Nicovf23/grupo-1800/Archivos de kicad/documentacion/cdj_revD_3D.png

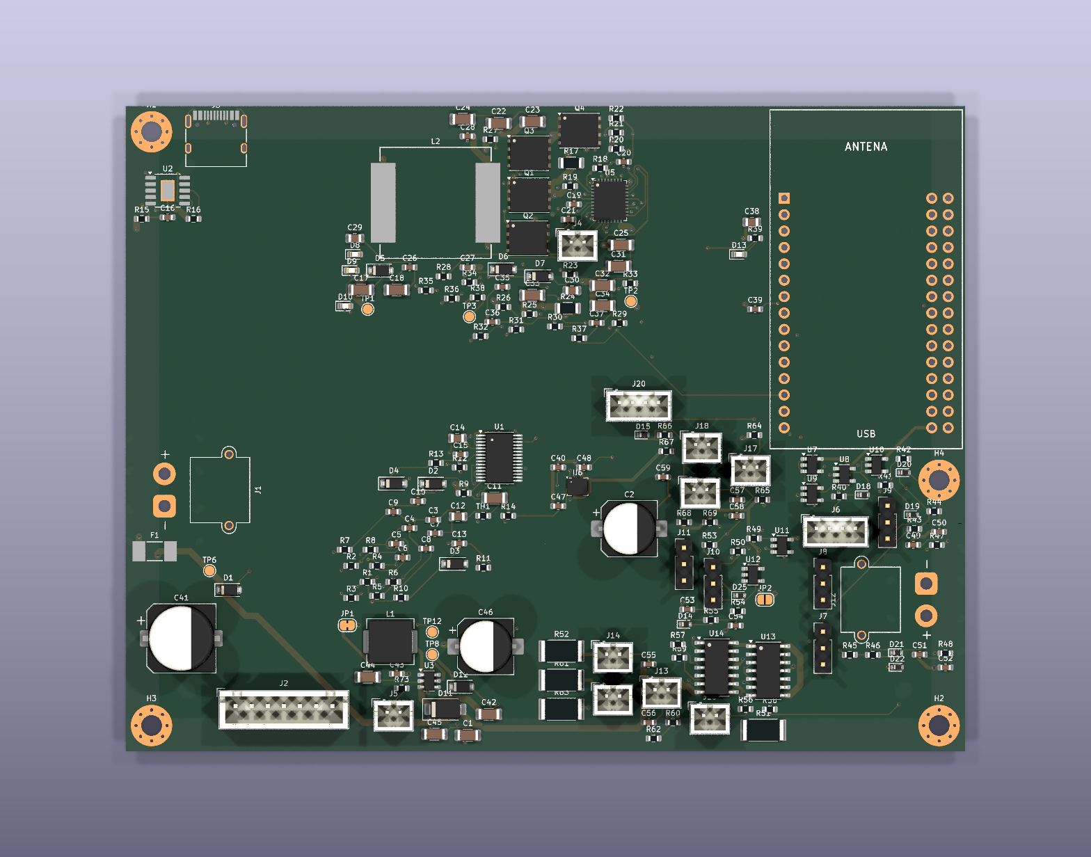
Archivos de kicad/documentacion/cdj_revD_3D.png
