Nicovf23/grupo-1800/Archivos de kicad/fabricacion_PRELIMINAR/cdj_revD.step

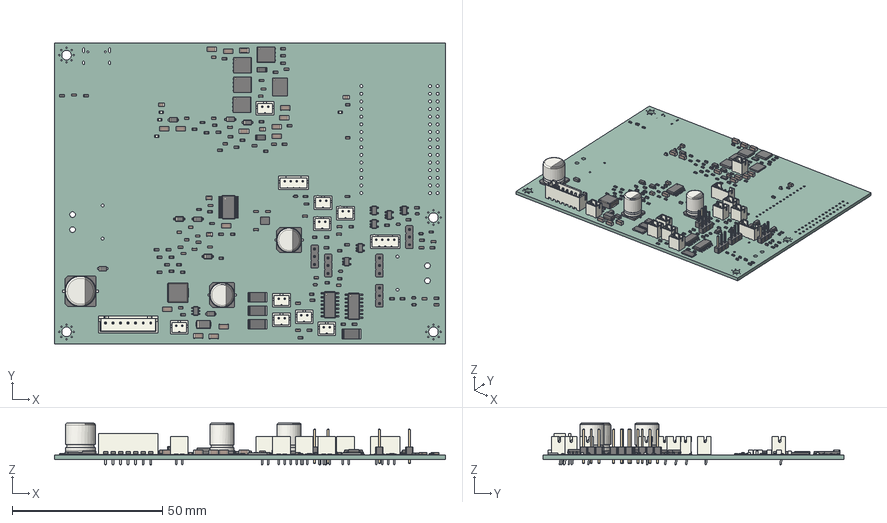
[picture p5: CAD file, 2026-11-05]
Archivos de kicad/fabricacion_PRELIMINAR/cdj_revD.step
130.0 x 100.0 x 13.9 mm
R_0603_1608Metric x 65
C_1206_3216Metric x 15
JST_PH_B2B-PH-K_1x02_P2.00mm_Vertical x 9
D_SOD-523 x 8
PinHeader_1x03_P2.54mm_Vertical x 5
SOT-23-5 x 6
C_0603_1608Metric x 36
TDSON-8-1 x 4
LED_0603_1608Metric x 4
D_SOD-123 x 5
R_2512_6332Metric x 4
SOIC-14_3.9x8.7mm_P1.27mm x 2
CP_Elec_8x10.5 x 2
C_0805_2012Metric x 5
D_SOD-123F x 3
D_SMA
LGA-14_3x2.5mm_P0.5mm_LayoutBorder3x4y
TSSOP-30_4.4x7.8mm_P0.5mm
R_1206_3216Metric x 2
QFN-36-1EP_5x6mm_P0.5mm_EP3.6x4.6mm
L_APV_APH0630
JST_PH_B4B-PH-K_1x04_P2.00mm_Vertical x 2
CP_Elec_10x10.5
TSOT-23-6
JST_XH_B7B-XH-A_1x07_P2.50mm_Vertical
cdj_revD_PCB
