Nicovf23/grupo-1800/Tareas/LA CAJA 1800.FCStd

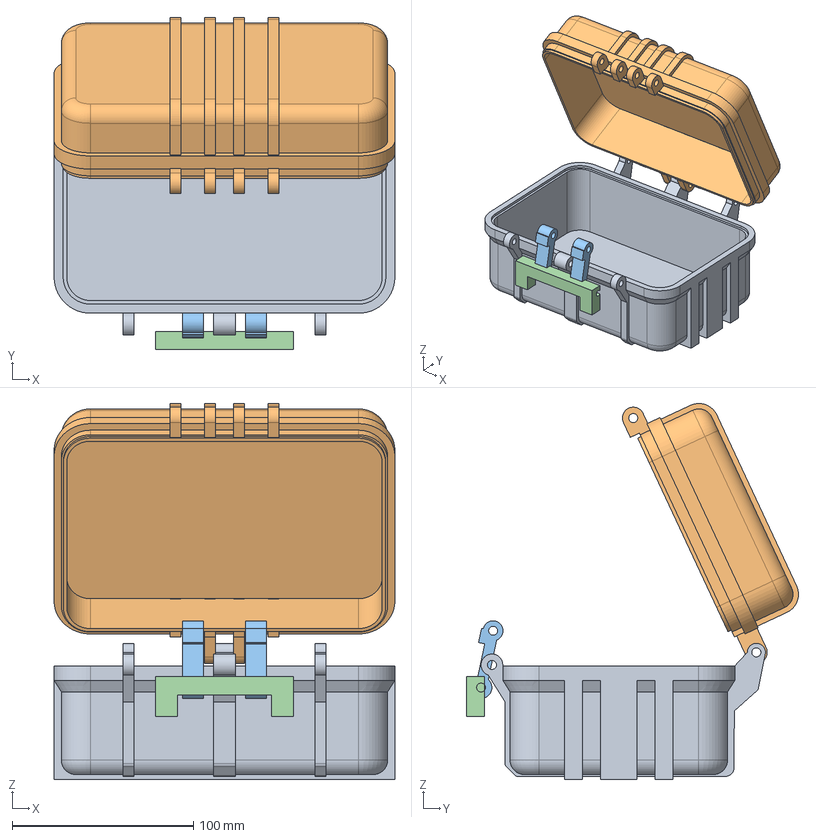
[picture p6: CAD file, 2026-10-15]
Tareas/LA CAJA 1800.FCStd
188.0 x 183.1 x 207.4 mm
cuerpo de caja
tapa
Cierres_Frontales
Asa_Transporte
