Nicovf23/grupo-1800/Tareas/cajita nueva.FCStd

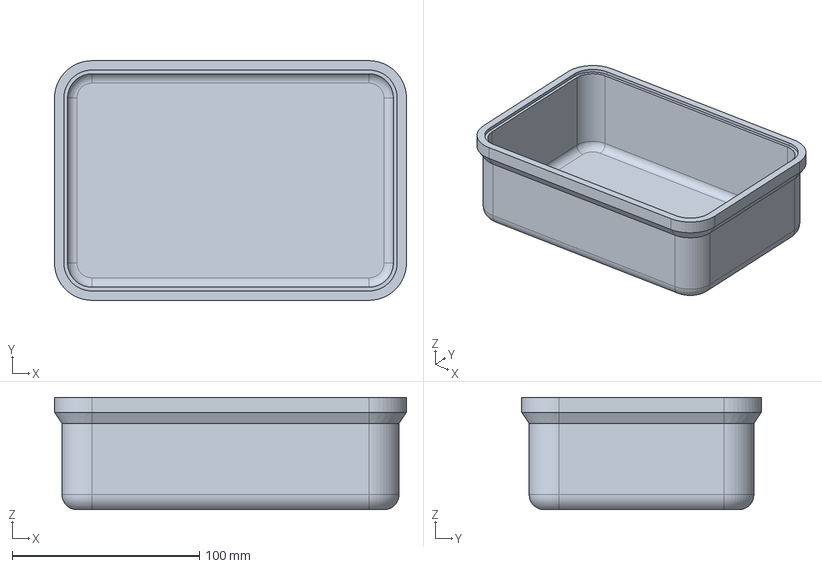
[picture p7: CAD file, 2026-10-15]
Tareas/cajita nueva.FCStd
188.0 x 128.0 x 60.0 mm
