Nicovf23/grupo-1800/Archivos de kicad/reportes/verificacion_netlist_revD.txt

pines esperados: 575  coinciden: 575  mal: 0
nets fusionadas: ninguna
