Nicovf23/grupo-1800/Archivos de kicad/documentacion/cdj_revD_esquematico.pdf

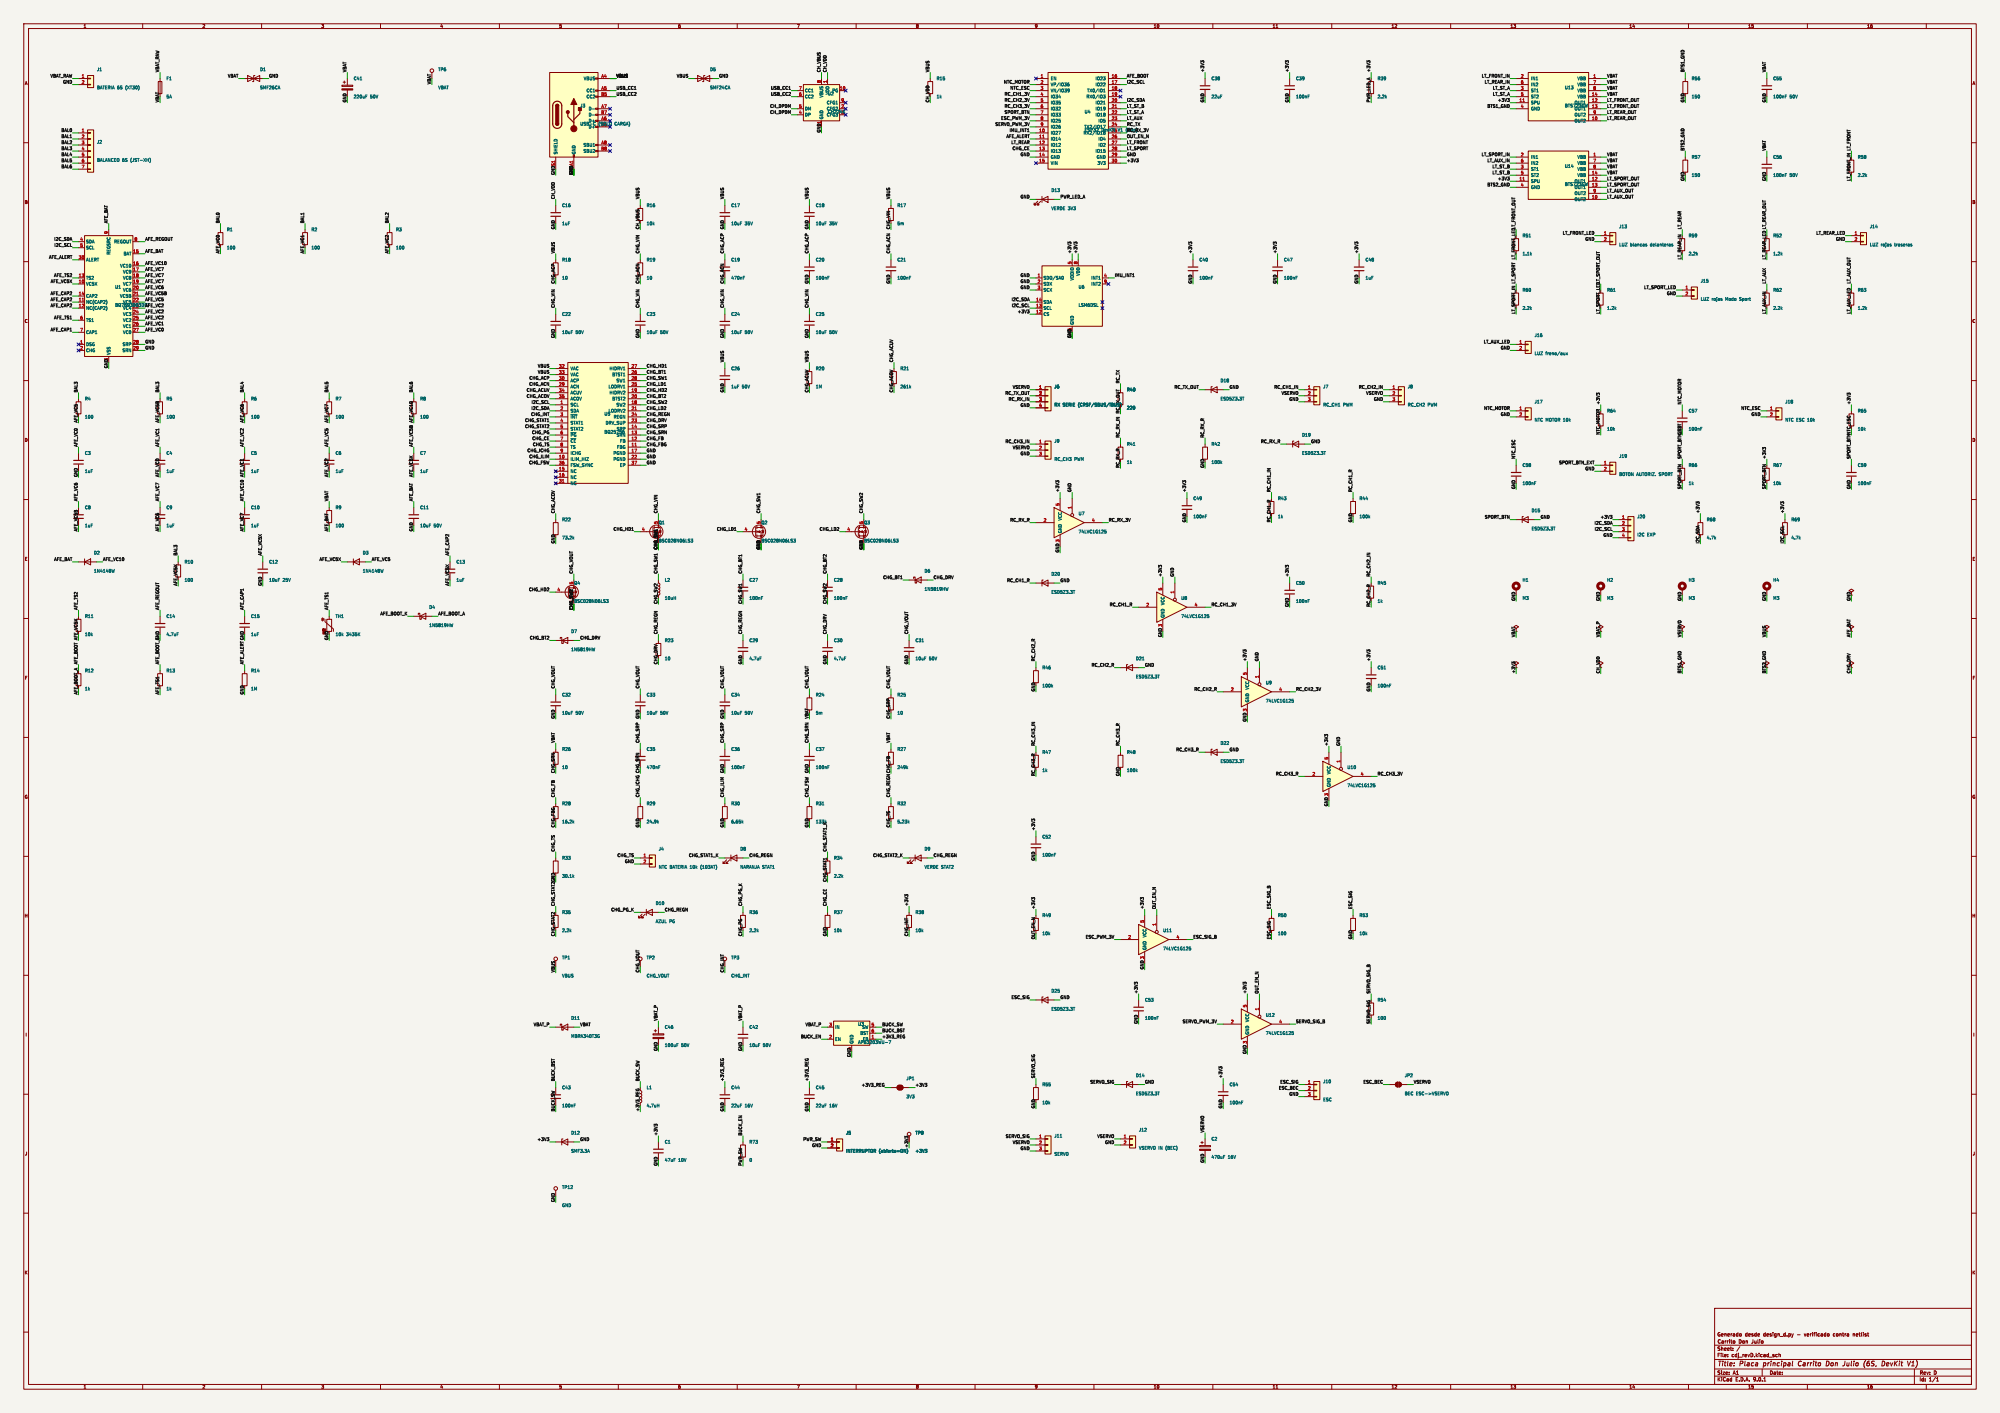
[picture p8: page 1]

9 REGOUT 8 BAT 15 VC10 16 VC9 17 VC8 18 VC7 19 VC6 20 VC5B 21 VC5 22 VC4 23 VC3 24 VC2 25 VC1 26 VC0 27 SRP 28 SRN 29 SDA 4 SCL 5 DSG 1 CHG 2 VSS

J6RX SERIE (CRSF/SBUS/iBUS) R10
