Nicovf23/grupo-1800/Archivos de kicad/proyecto_revD/cdj_revD.kicad_pcb

## KiCad design Archivos de kicad/proyecto_revD/cdj_revD.kicad_pcb (2026-11-05)

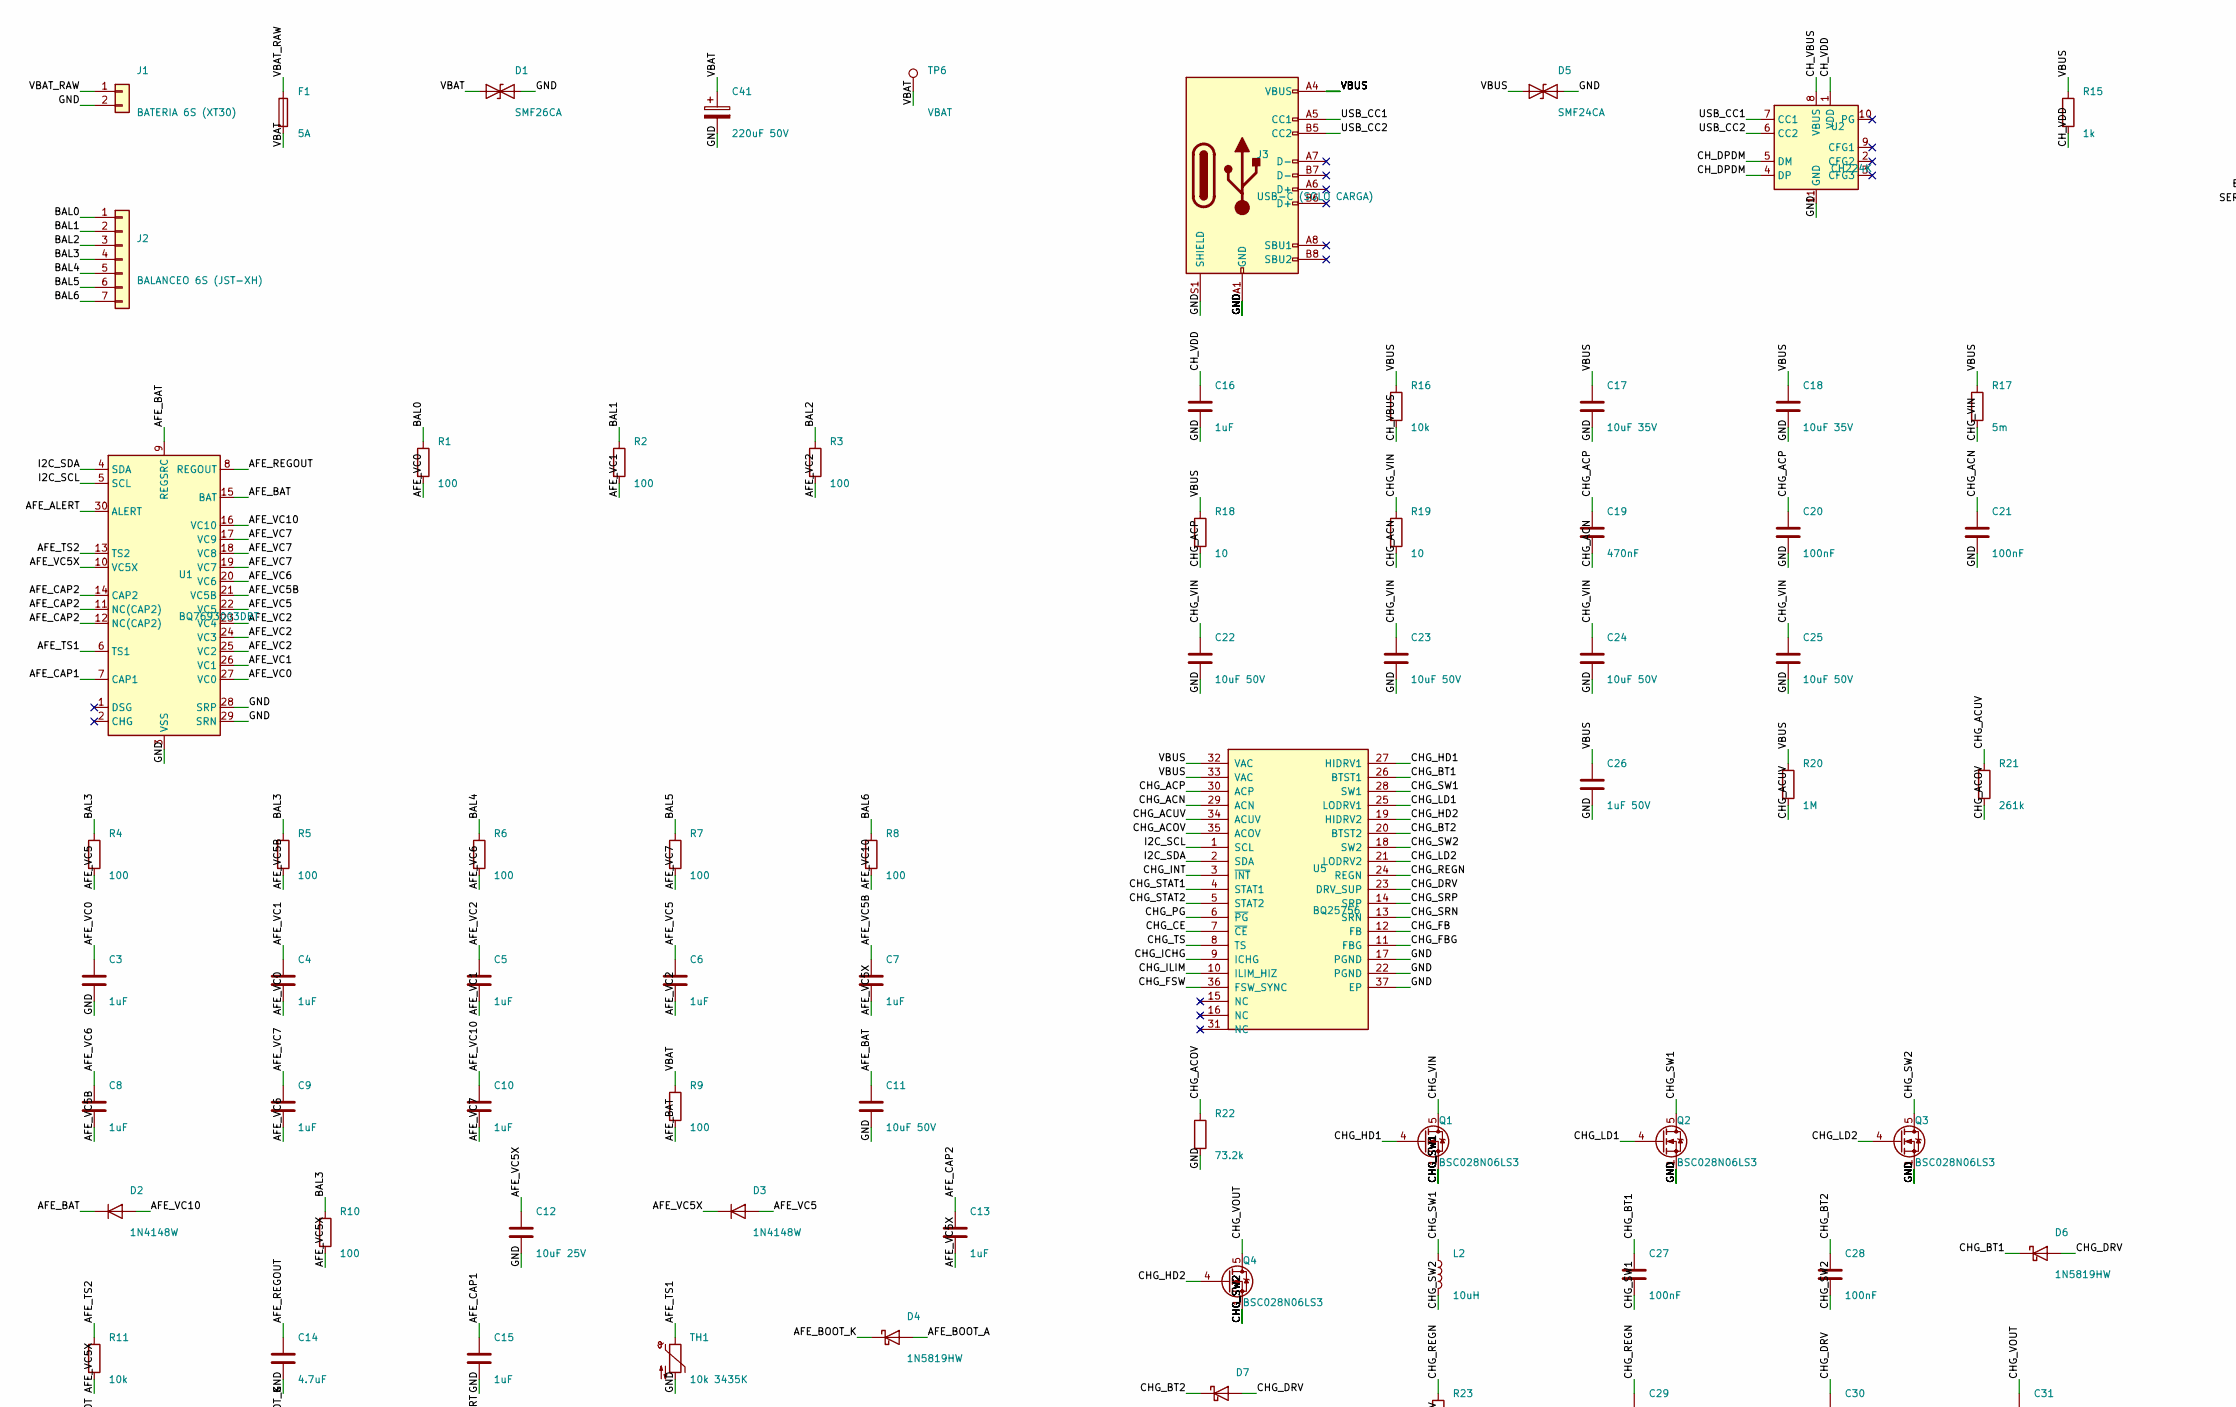
[picture p9: schematic cdj_revD.kicad_sch, Placa principal Carrito Don Julio (6S, DevKit V1), part in row 1, column 1]

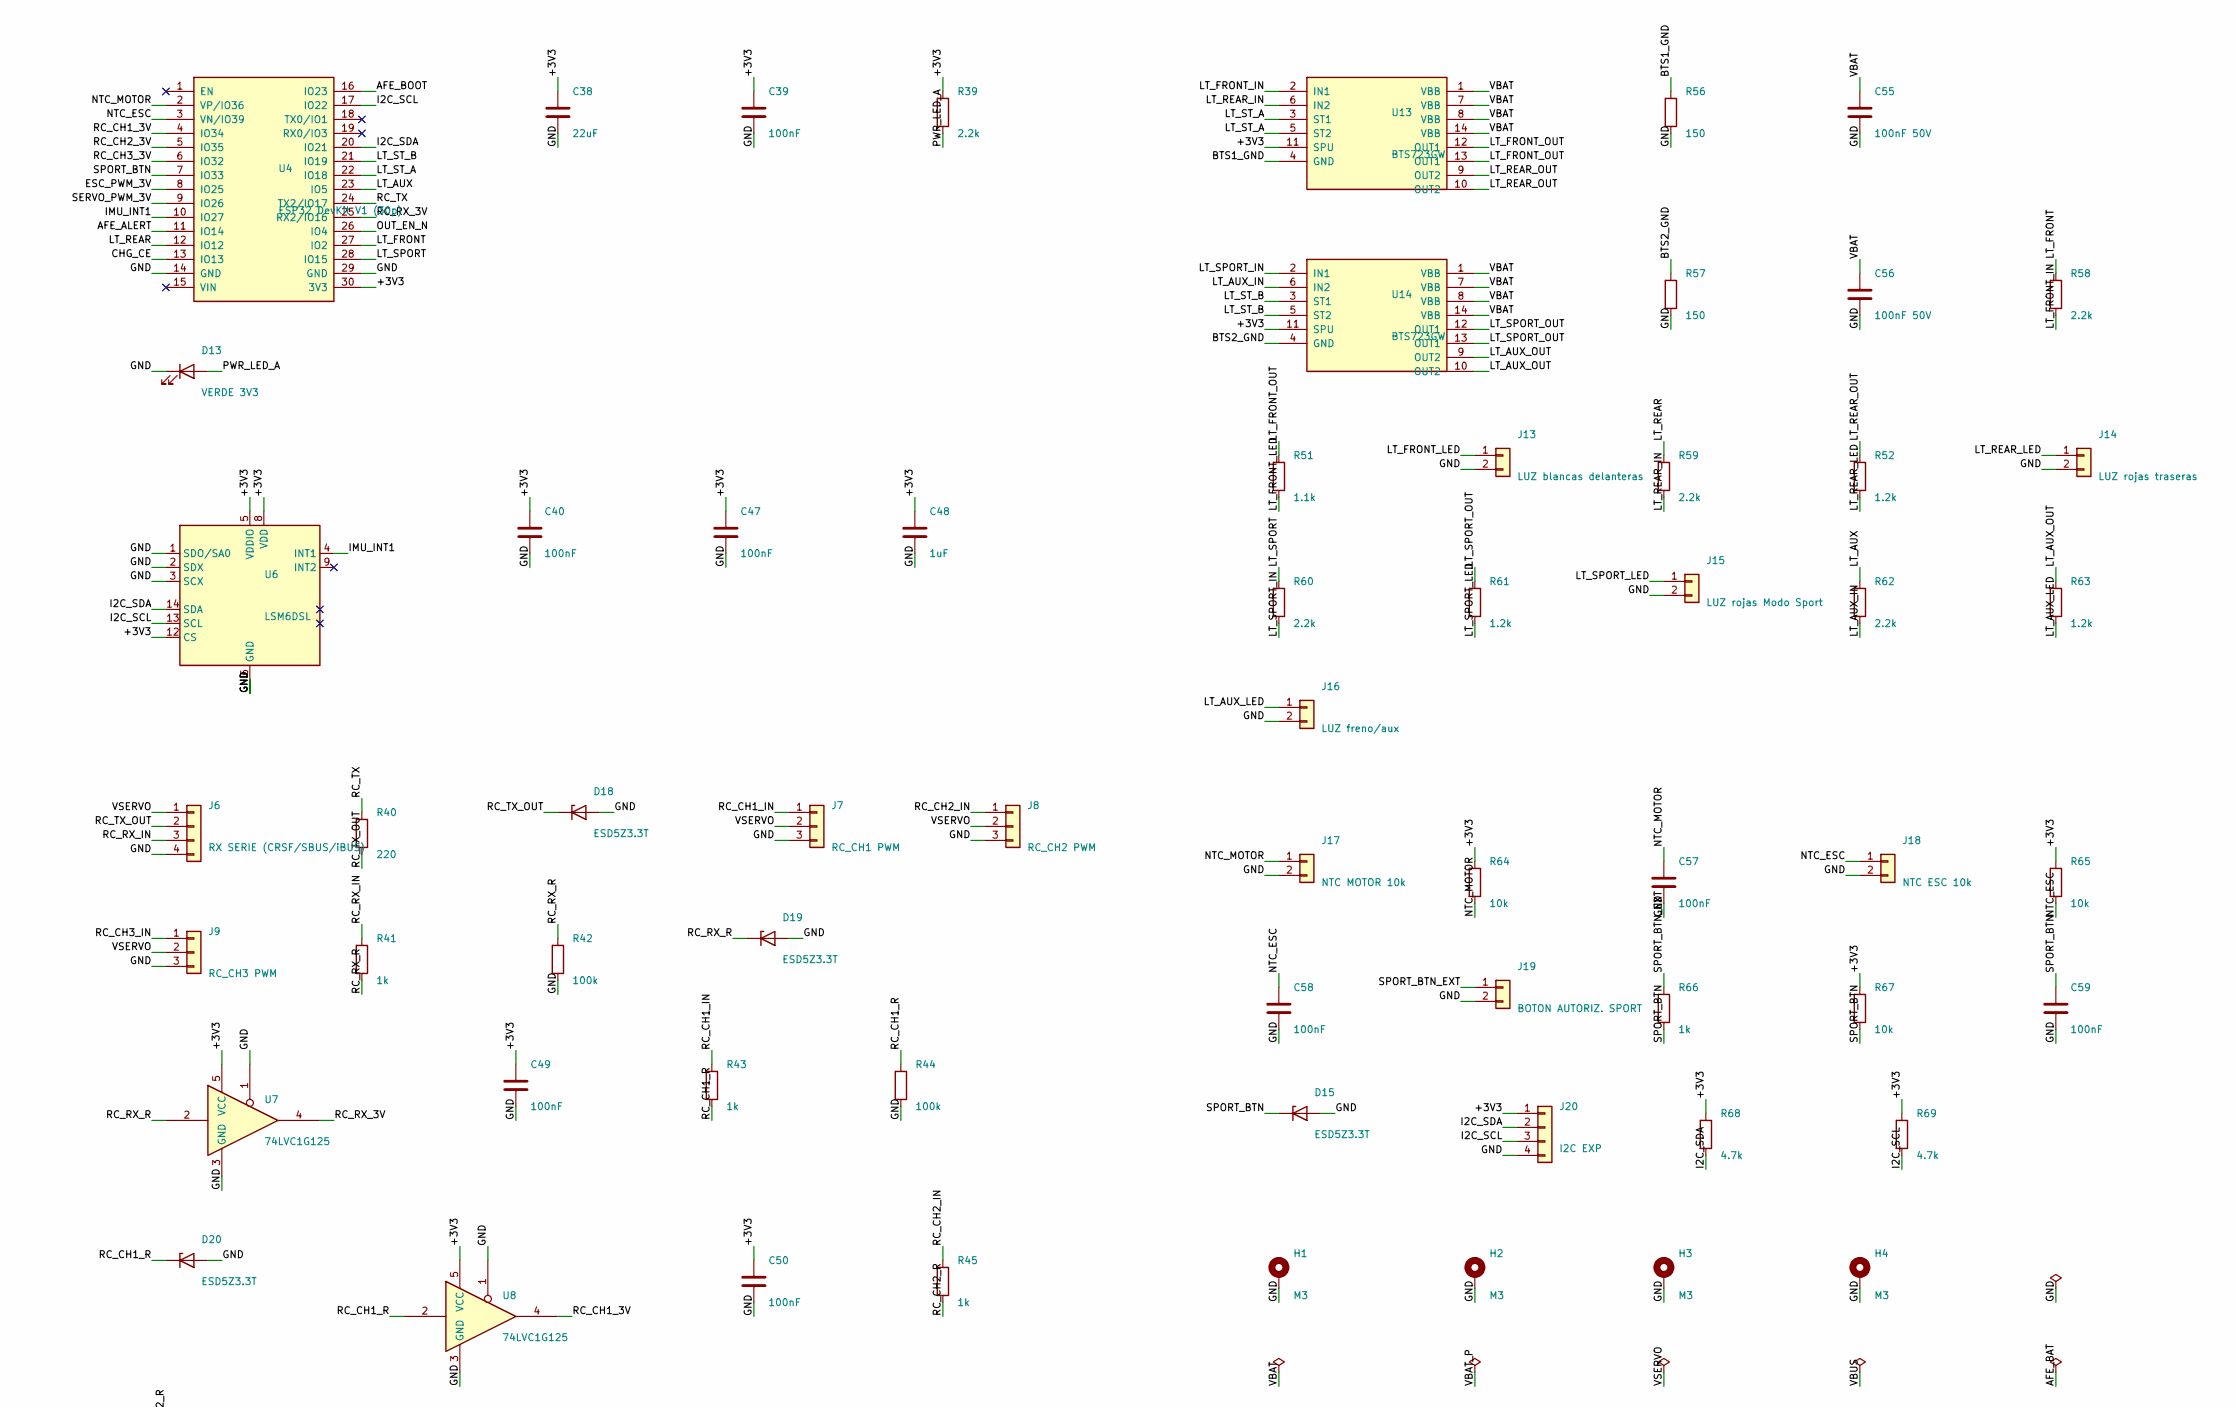
[picture p10: schematic cdj_revD.kicad_sch, Placa principal Carrito Don Julio (6S, DevKit V1), part in row 1, column 2]

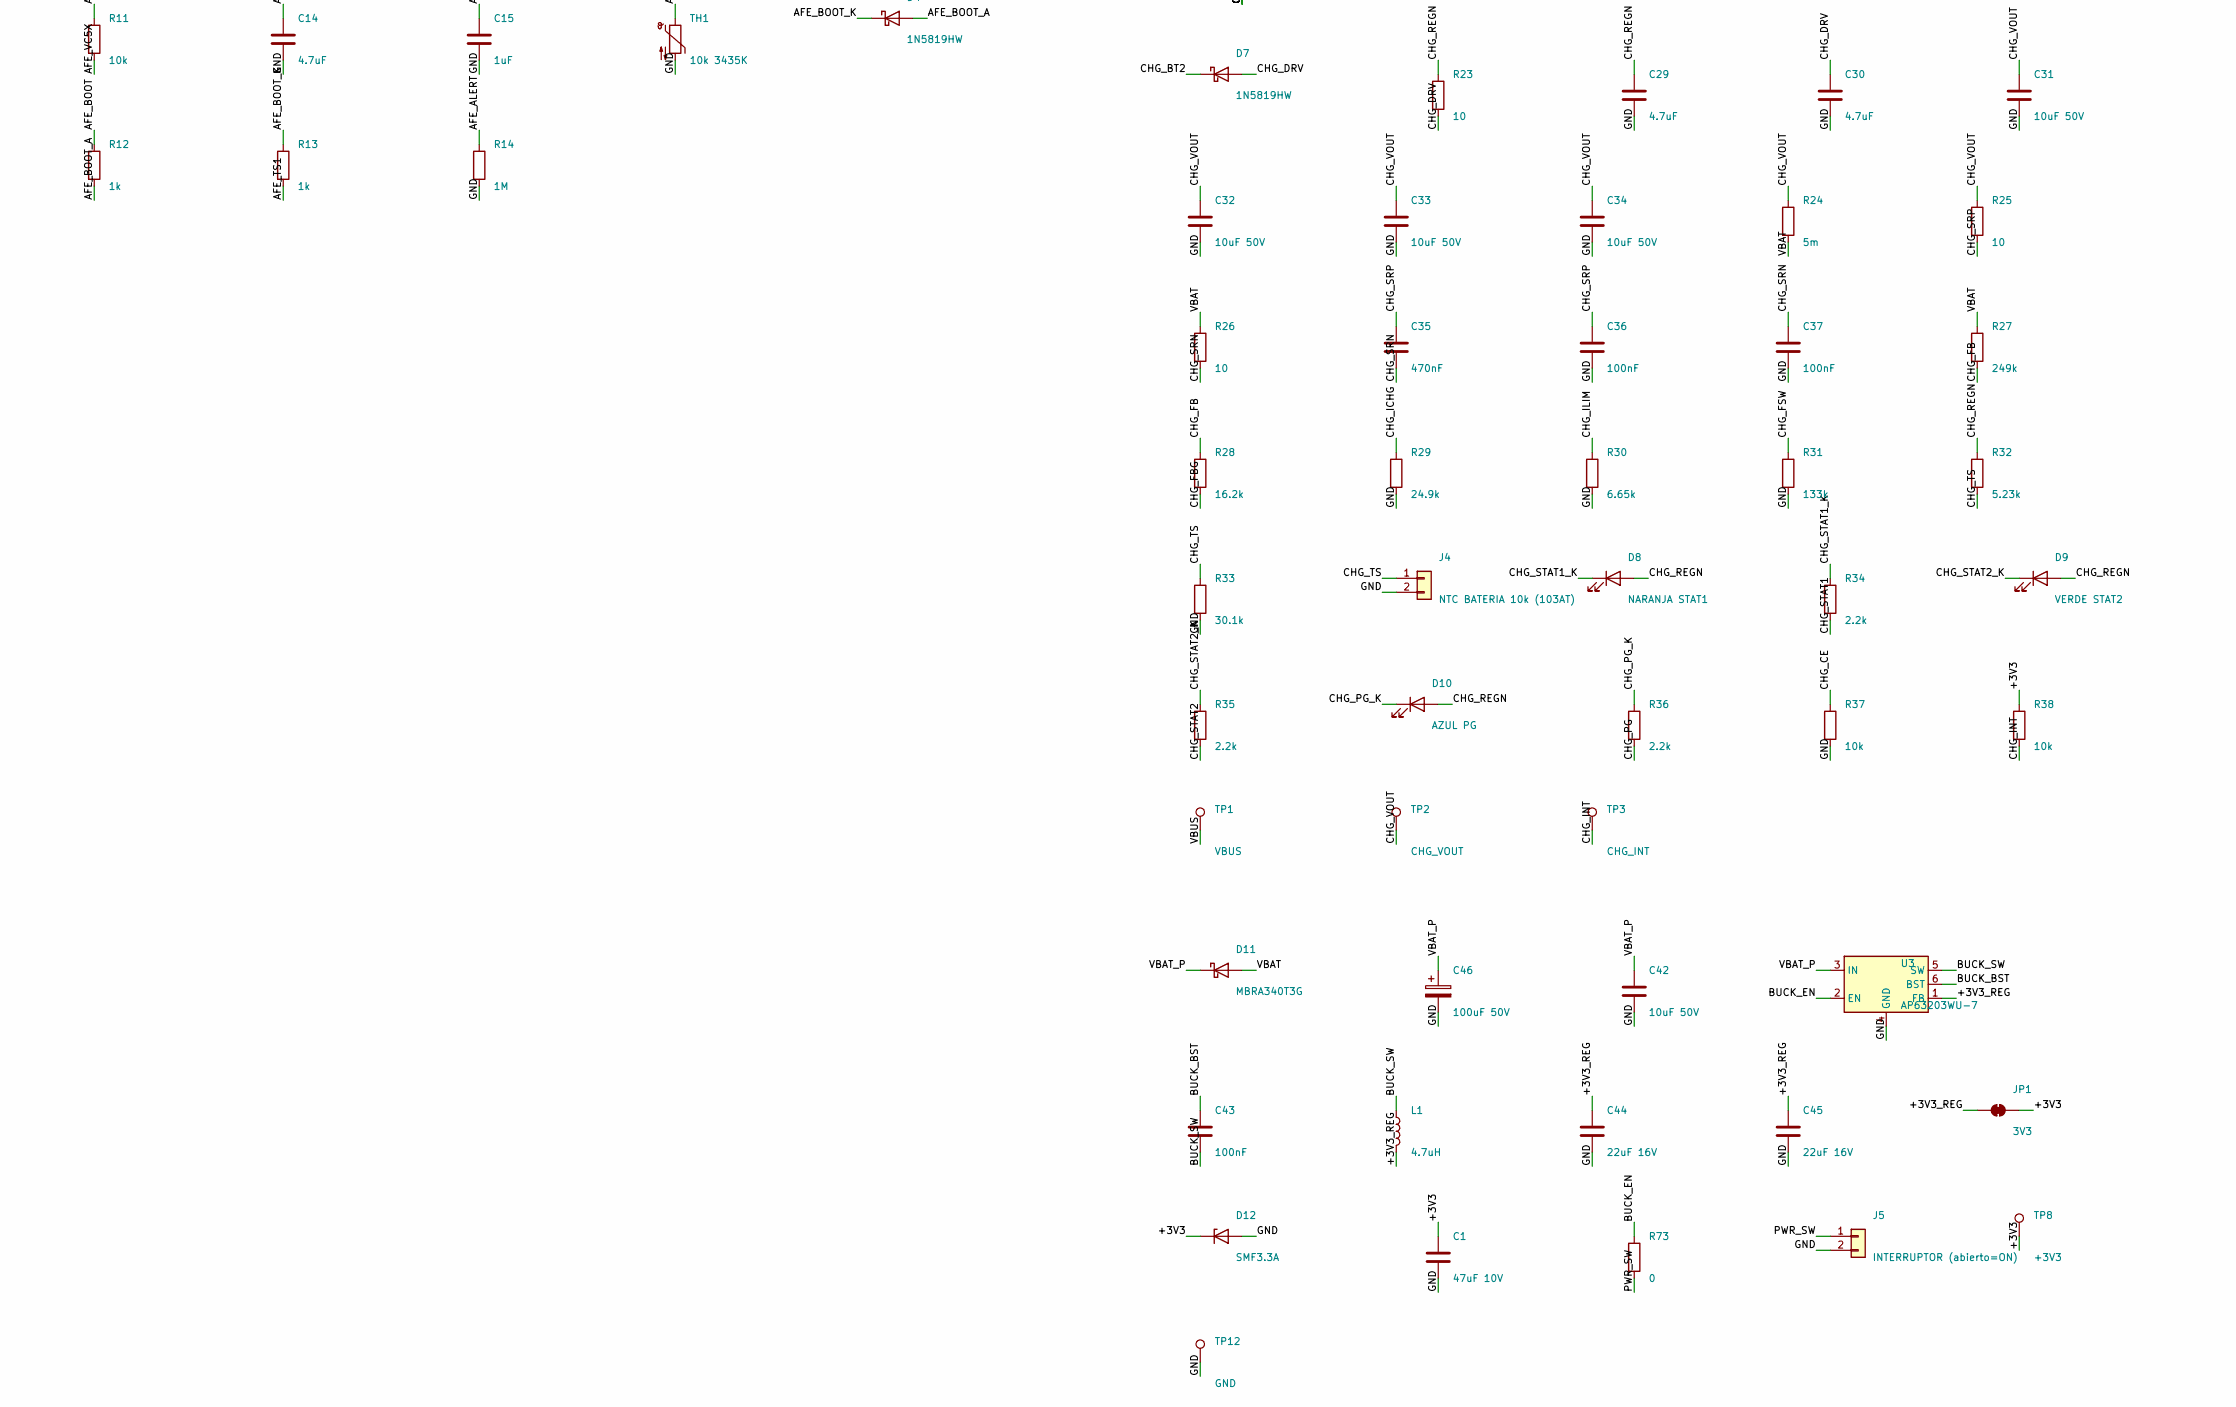
[picture p11: schematic cdj_revD.kicad_sch, Placa principal Carrito Don Julio (6S, DevKit V1), part in row 2, column 1]

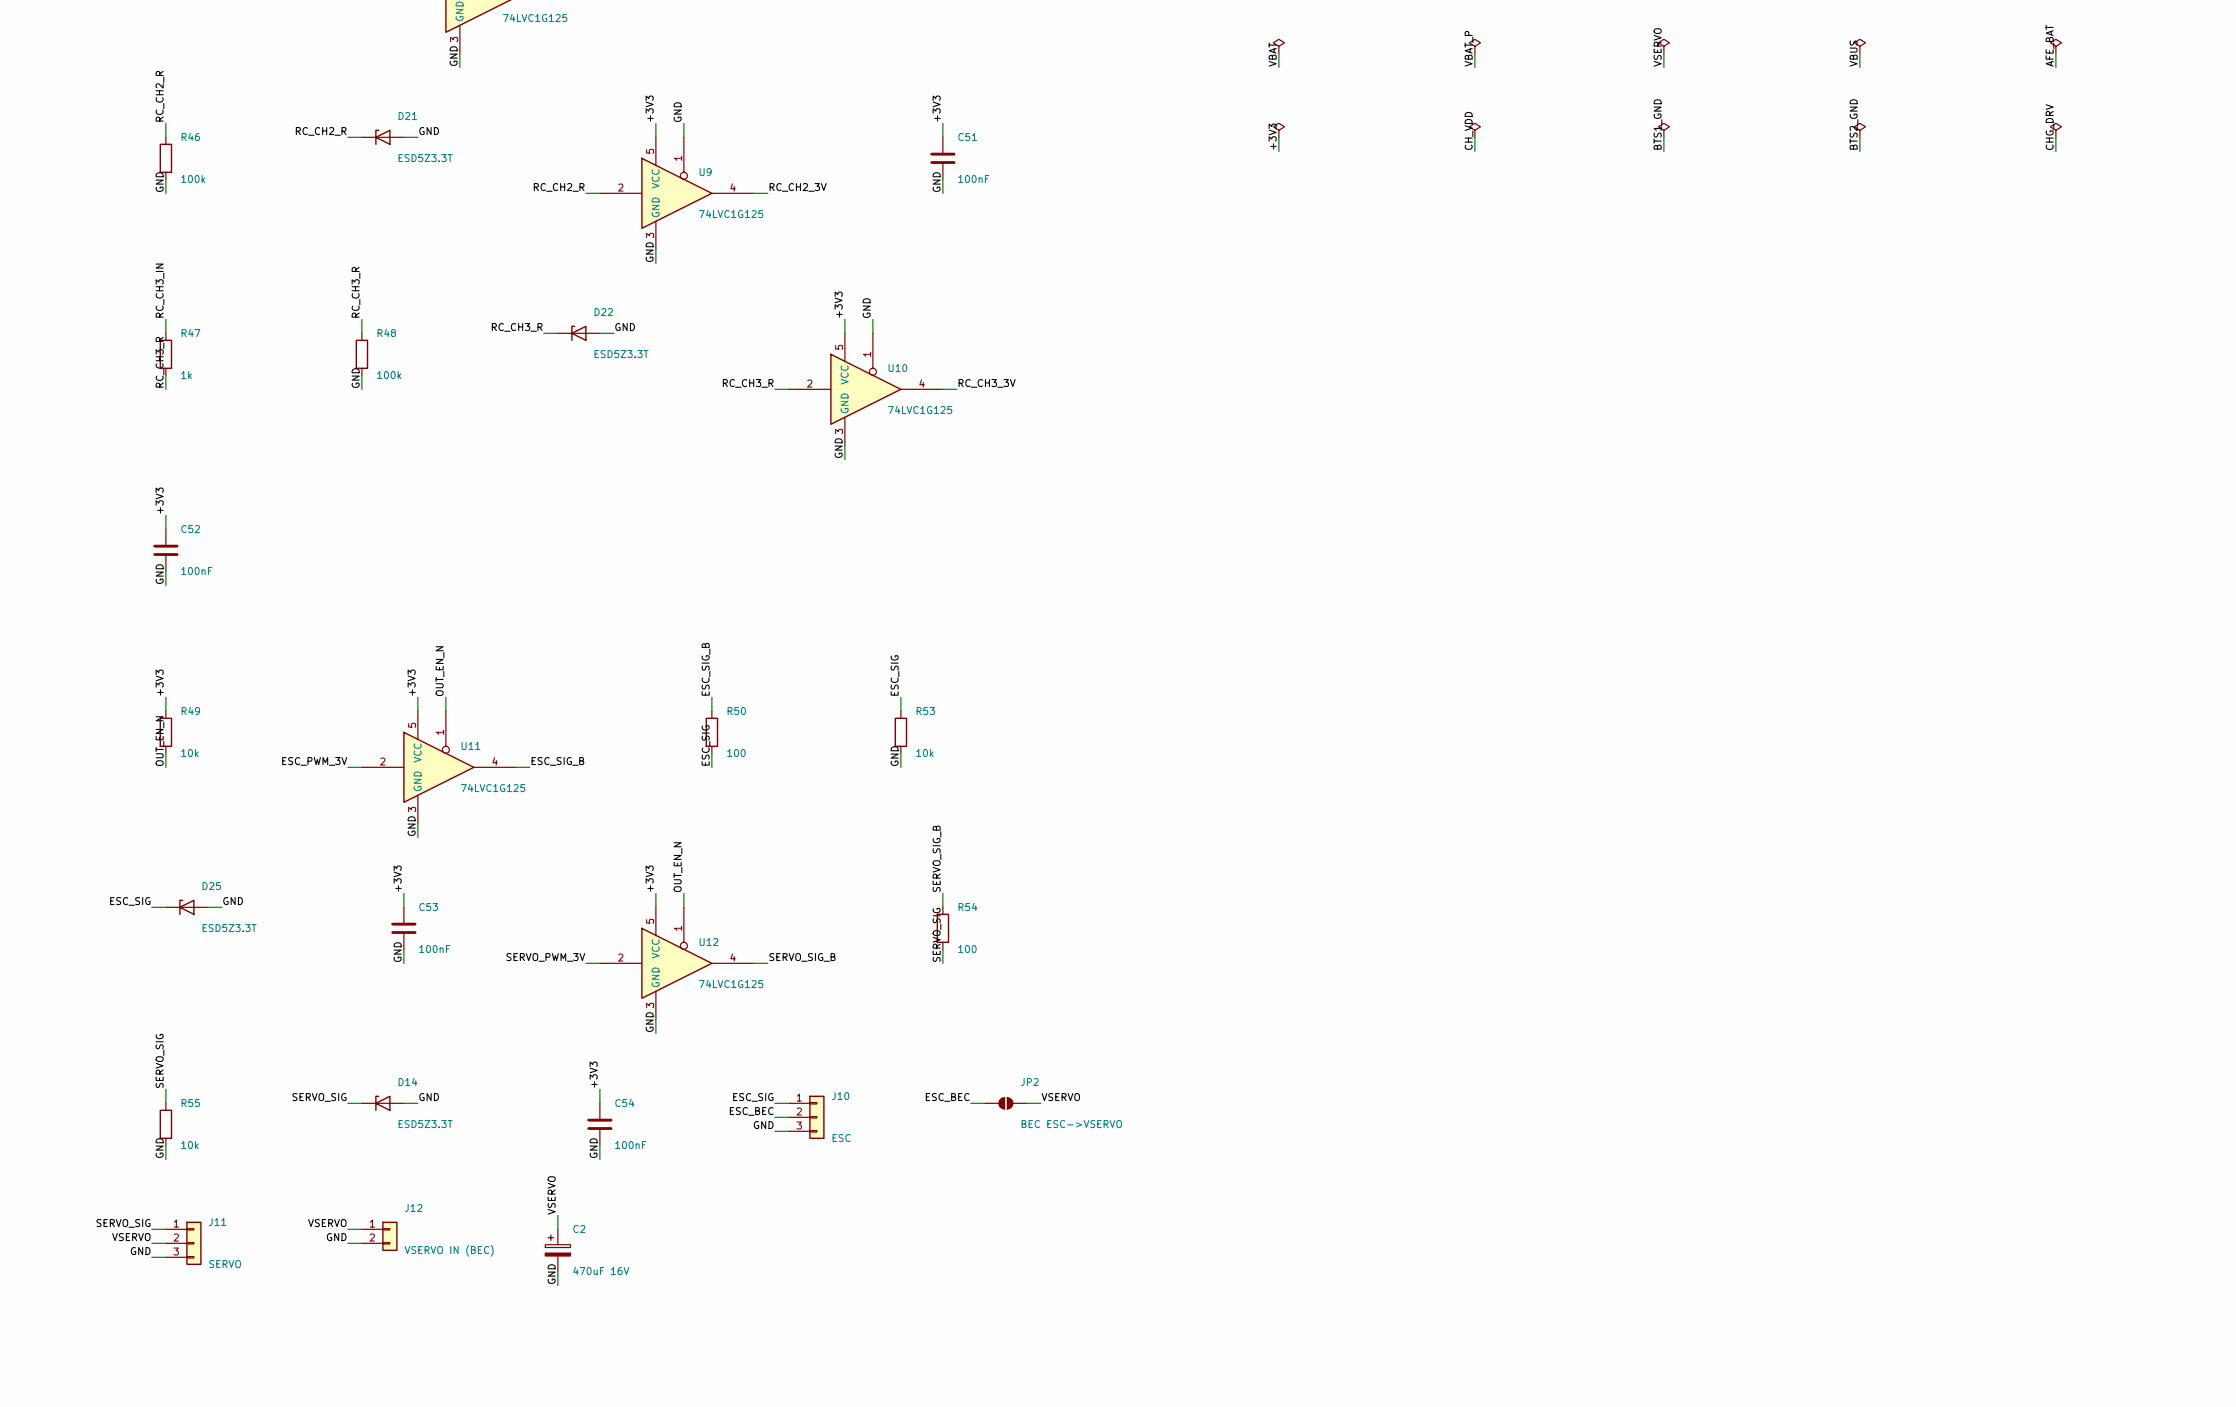
[picture p12: schematic cdj_revD.kicad_sch, Placa principal Carrito Don Julio (6S, DevKit V1), part in row 2, column 2]

Parts:
C1: 47uF 10V; C_1206_3216Metric; MPN X5R 1206 10V
C2: 470uF 16V; CP_Elec_8x10.5; MPN Aluminio 470uF/16V low-ESR
C3, C4, C5, C6, C7, C8, C9, C10, C13: 1uF; C_0603_1608Metric; MPN X7R 0603 25V
C11: 10uF 50V; C_1206_3216Metric; MPN X7R 1206 50V
C12: 10uF 25V; C_0805_2012Metric; MPN X7R 0805 25V
C14: 4.7uF; C_0805_2012Metric; MPN X7R 0805 10V
C15, C16, C48: 1uF; C_0603_1608Metric; MPN X7R 0603
C17, C18: 10uF 35V; C_1206_3216Metric; MPN X5R 1206 35V
C19, C35: 470nF; C_0603_1608Metric; MPN X7R 0603 50V
C20, C21, C36, C37: 100nF; C_0603_1608Metric; MPN X7R 0603 50V
C22, C23, C24, C25, C31, C32, C33, C34, C42: 10uF 50V; C_1206_3216Metric; MPN X5R 1206 50V
C26: 1uF 50V; C_0603_1608Metric; MPN X7R 0603 50V
C27, C28, C43: 100nF; C_0603_1608Metric; MPN X7R 0603 25V
C29, C30: 4.7uF; C_0805_2012Metric; MPN X7R 0805 16V
C38: 22uF; C_0805_2012Metric; MPN X5R 0805 10V
C39, C40, C47, C49, C50, C51, C52, C53, C54, C57, C58, C59: 100nF; C_0603_1608Metric; MPN X7R 0603
C41: 220uF 50V; CP_Elec_10x10.5; MPN Aluminio 220uF/50V
C44, C45: 22uF 16V; C_1206_3216Metric; MPN X5R 1206 16V
C46: 100uF 50V; CP_Elec_8x10.5; MPN Aluminio 100uF/50V
C55, C56: 100nF 50V; C_0603_1608Metric; MPN X7R 0603 50V
D1: SMF26CA; D_SOD-123F; MPN Littelfuse SMF26CA
D2, D3: 1N4148W; D_SOD-123; MPN Diodes 1N4148W-7-F
D4, D6, D7: 1N5819HW; D_SOD-123; MPN Diodes 1N5819HW-7-F
D5: SMF24CA; D_SOD-123F; MPN Littelfuse SMF24CA
D8: NARANJA STAT1; LED_0603_1608Metric; MPN LED 0603
D9: VERDE STAT2; LED_0603_1608Metric; MPN LED 0603
D10: AZUL PG; LED_0603_1608Metric; MPN LED 0603
D11: MBRA340T3G; D_SMA; MPN onsemi MBRA340T3G
D12: SMF3.3A; D_SOD-123F; MPN Littelfuse SMF3.3A (verificar sufijo)
D13: VERDE 3V3; LED_0603_1608Metric; MPN LED verde 0603
D14, D15, D18, D19, D20, D21, D22, D25: ESD5Z3.3T; D_SOD-523; MPN onsemi ESD5Z3.3T1G
F1: 5A; Fuse_Littelfuse-NANO2-451_453; MPN Littelfuse 0451005.MRL (5A, verificar V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
H1, H2, H3, H4: M3; MountingHole_3.2mm_M3_Pad_Via; MPN M3 + arandela antivibracion
J1: BATERIA 6S (XT30); AMASS_XT30PW-M_1x02_P2.50mm_Horizontal; MPN AMASS XT30PW-M
J2: BALANCEO 6S (JST-XH); JST_XH_B7B-XH-A_1x07_P2.50mm_Vertical; MPN JST B7B-XH-A
J3: USB-C (SOLO CARGA); USB_C_Receptacle_HRO_TYPE-C-31-M-12; MPN HRO TYPE-C-31-M-12
J4: NTC BATERIA 10k (103AT); JST_PH_B2B-PH-K_1x02_P2.00mm_Vertical; MPN JST B2B-PH-K-S
J5: INTERRUPTOR (abierto=ON); JST_PH_B2B-PH-K_1x02_P2.00mm_Vertical; MPN JST B2B-PH-K-S
J6: RX SERIE (CRSF/SBUS/iBUS); JST_PH_B4B-PH-K_1x04_P2.00mm_Vertical; MPN JST B4B-PH-K-S
J7: RC_CH1 PWM; PinHeader_1x03_P2.54mm_Vertical; MPN Header 1x03 2.54mm
J8: RC_CH2 PWM; PinHeader_1x03_P2.54mm_Vertical; MPN Header 1x03 2.54mm
J9: RC_CH3 PWM; PinHeader_1x03_P2.54mm_Vertical; MPN Header 1x03 2.54mm
J10: ESC; PinHeader_1x03_P2.54mm_Vertical; MPN Header 1x03 2.54mm
J11: SERVO; PinHeader_1x03_P2.54mm_Vertical; MPN Header 1x03 2.54mm
J12: VSERVO IN (BEC); AMASS_XT30PW-M_1x02_P2.50mm_Horizontal; MPN AMASS XT30PW-M
J13: LUZ blancas delanteras; JST_PH_B2B-PH-K_1x02_P2.00mm_Vertical; MPN JST B2B-PH-K-S
J14: LUZ rojas traseras; JST_PH_B2B-PH-K_1x02_P2.00mm_Vertical; MPN JST B2B-PH-K-S
J15: LUZ rojas Modo Sport; JST_PH_B2B-PH-K_1x02_P2.00mm_Vertical; MPN JST B2B-PH-K-S
J16: LUZ freno/aux; JST_PH_B2B-PH-K_1x02_P2.00mm_Vertical; MPN JST B2B-PH-K-S
J17: NTC MOTOR 10k; JST_PH_B2B-PH-K_1x02_P2.00mm_Vertical; MPN JST B2B-PH-K-S
J18: NTC ESC 10k; JST_PH_B2B-PH-K_1x02_P2.00mm_Vertical; MPN JST B2B-PH-K-S
J19: BOTON AUTORIZ. SPORT; JST_PH_B2B-PH-K_1x02_P2.00mm_Vertical; MPN JST B2B-PH-K-S
J20: I2C EXP; JST_PH_B4B-PH-K_1x04_P2.00mm_Vertical; MPN JST B4B-PH-K-S
JP1: 3V3; SolderJumper-2_P1.3mm_Bridged_RoundedPad1.0x1.5mm; MPN Puente soldadura (cerrado)
JP2: BEC ESC->VSERVO; SolderJumper-2_P1.3mm_Open_RoundedPad1.0x1.5mm; MPN Puente soldadura (abierto)
L1: 4.7uH; L_APV_APH0630; MPN APV APH0630T4R7M
L2: 10uH; L_Vishay_IHLP-6767; MPN Vishay IHLP6767GZER100M01 (Tabla 7-1)
Q1, Q2, Q3, Q4: BSC028N06LS3; TDSON-8-1; MPN Infineon BSC028N06LS3 (60V 2.8mOhm, log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
R1, R2, R3, R4, R5, R6, R7, R8, R9, R10, R50, R54: 100; R_0603_1608Metric; MPN 1% 0603
R11, R16, R37, R38, R49, R53, R55, R64, R65, R67: 10k; R_0603_1608Metric; MPN 1% 0603
R12, R13, R15, R41, R43, R45, R47, R66: 1k; R_0603_1608Metric; MPN 1% 0603
R14, R20: 1M; R_0603_1608Metric; MPN 1% 0603
R17, R24: 5m; R_1206_3216Metric; MPN Shunt 5mOhm 1206 1W
R18, R19, R23, R25, R26: 10; R_0603_1608Metric; MPN 1% 0603
R21: 261k; R_0603_1608Metric; MPN 1% 0603
R22: 73.2k; R_0603_1608Metric; MPN 1% 0603
R27: 249k; R_0603_1608Metric; MPN 1% 0603
R28: 16.2k; R_0603_1608Metric; MPN 1% 0603
R29: 24.9k; R_0603_1608Metric; MPN 1% 0603
R30: 6.65k; R_0603_1608Metric; MPN 1% 0603
R31: 133k; R_0603_1608Metric; MPN 1% 0603
R32: 5.23k; R_0603_1608Metric; MPN 1% 0603
R33: 30.1k; R_0603_1608Metric; MPN 1% 0603
R34, R35, R36, R39, R58, R59, R60, R62: 2.2k; R_0603_1608Metric; MPN 1% 0603
R40: 220; R_0603_1608Metric; MPN 1% 0603
R42, R44, R46, R48: 100k; R_0603_1608Metric; MPN 1% 0603
R51: 1.1k; R_2512_6332Metric; MPN 2512 1W (1 LED a 6S: 0.45W; 0R si el mo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
R52, R61, R63: 1.2k; R_2512_6332Metric; MPN 2512 1W (1 LED a 6S: 0.45W; 0R si el mo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
R56, R57: 150; R_0603_1608Metric; MPN 1% 0603
R68, R69: 4.7k; R_0603_1608Metric; MPN 1% 0603
R73: 0; R_0603_1608Metric; MPN 1% 0603
TH1: 10k 3435K; R_0603_1608Metric; MPN Murata NCP18XH103F03RB
TP1: VBUS; TestPoint_Pad_D1.5mm; MPN Pad de prueba
TP2: CHG_VOUT; TestPoint_Pad_D1.5mm; MPN Pad de prueba
TP3: CHG_INT; TestPoint_Pad_D1.5mm; MPN Pad de prueba
TP6: VBAT; TestPoint_Pad_D1.5mm; MPN Pad de prueba
TP8: +3V3; TestPoint_Pad_D1.5mm; MPN Pad de prueba
TP12: GND; TestPoint_Pad_D1.5mm; MPN Pad de prueba
U1: BQ7693003DBT; TSSOP-30_4.4x7.8mm_P0.5mm; MPN TI BQ7693003DBTR (REGOUT 3.3V, I2C 0x08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
U2: CH224K; SSOP-10-1EP_3.9x4.9mm_P1mm_EP2.1x3.3mm; MPN WCH CH224K (LCSC C970725)
U3: AP63203WU-7; TSOT-23-6; MPN Diodes AP63203WU-7
U4: ESP32 DevKit V1 (30p); ESP32_DevKit_V1_30P; MPN DOIT ESP32 DevKit V1 30 pines + 2x tira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
U5: BQ25756; QFN-36-1EP_5x6mm_P0.5mm_EP3.6x4.6mm; MPN TI BQ25756RRVR (LCSC C19272232)
U6: LSM6DSL; LGA-14_3x2.5mm_P0.5mm_LayoutBorder3x4y; MPN ST LSM6DSLTR
U7, U8, U9, U10, U11, U12: 74LVC1G125; SOT-23-5; MPN TI SN74LVC1G125DBVR
U13, U14: BTS723GW; SOIC-14_3.9x8.7mm_P1.27mm; MPN Infineon BTS723GWXUMA1

Connections:
/+3V3: C1.1, C38.1, C39.1, C40.1, C47.1, C48.1, C49.1, C50.1, C51.1, C52.1, C53.1, C54.1, D12.1 (K), J20.1, JP1.2 (B), R38.1, R39.1, R49.1, R64.1, R65.1, R67.1, R68.1, R69.1, TP8.1, U4.30 (3V3), U6.5 (VDDIO), U6.8 (VDD), U6.12 (CS), U7.5 (VCC), U8.5 (VCC), U9.5 (VCC), U10.5 (VCC), U11.5 (VCC), U12.5 (VCC), U13.11 (SPU), U14.11 (SPU)
/+3V3_REG: C44.1, C45.1, JP1.1 (A), L1.2, U3.1 (FB)
/AFE_ALERT: R14.1, U1.30 (ALERT), U4.11 (IO14)
/AFE_BAT: C11.1, D2.1 (K), R9.2, U1.9 (REGSRC), U1.15 (BAT)
/AFE_BOOT: R12.1, U4.16 (IO23)
/AFE_BOOT_A: D4.2 (A), R12.2
/AFE_BOOT_K: D4.1 (K), R13.1
/AFE_CAP1: C15.1, U1.7 (CAP1)
/AFE_CAP2: C13.1, U1.11 (NC(CAP2)), U1.12 (NC(CAP2)), U1.14 (CAP2)
/AFE_REGOUT: C14.1, U1.8 (REGOUT)
/AFE_TS1: R13.2, TH1.1, U1.6 (TS1)
/AFE_TS2: R11.1, U1.13 (TS2)
/AFE_VC0: C3.1, C4.2, R1.2, U1.27 (VC0)
/AFE_VC1: C4.1, C5.2, R2.2, U1.26 (VC1)
/AFE_VC2: C5.1, C6.2, R3.2, U1.23 (VC4), U1.24 (VC3), U1.25 (VC2)
/AFE_VC5: C6.1, D3.2 (A), R4.2, U1.22 (VC5)
/AFE_VC5B: C7.1, C8.2, R5.2, U1.21 (VC5B)
/AFE_VC5X: C7.2, C12.1, C13.2, D3.1 (K), R10.2, R11.2, U1.10 (VC5X)
/AFE_VC6: C8.1, C9.2, R6.2, U1.20 (VC6)
/AFE_VC7: C9.1, C10.2, R7.2, U1.17 (VC9), U1.18 (VC8), U1.19 (VC7)
/AFE_VC10: C10.1, D2.2 (A), R8.2, U1.16 (VC10)
/BAL0: J2.1, R1.1
/BAL1: J2.2, R2.1
/BAL2: J2.3, R3.1
/BAL3: J2.4, R4.1, R5.1, R10.1
/BAL4: J2.5, R6.1
/BAL5: J2.6, R7.1
/BAL6: J2.7, R8.1
/BTS1_GND: R56.1, U13.4 (GND)
/BTS2_GND: R57.1, U14.4 (GND)
/BUCK_BST: C43.1, U3.6 (BST)
/BUCK_EN: R73.1, U3.2 (EN)
/BUCK_SW: C43.2, L1.1, U3.5 (SW)
/CHG_ACN: C19.2, C21.1, R19.2, U5.29 (ACN)
/CHG_ACOV: R21.2, R22.1, U5.35 (ACOV)
/CHG_ACP: C19.1, C20.1, R18.2, U5.30 (ACP)
/CHG_ACUV: R20.2, R21.1, U5.34 (ACUV)
/CHG_BT1: C27.1, D6.1 (K), U5.26 (BTST1)
/CHG_BT2: C28.1, D7.1 (K), U5.20 (BTST2)
/CHG_CE: R37.1, U4.13 (IO13), U5.7 (~CE)
/CHG_DRV: C30.1, D6.2 (A), D7.2 (A), R23.2, U5.23 (DRV_SUP)
/CHG_FB: R27.2, R28.1, U5.12 (FB)
/CHG_FBG: R28.2, U5.11 (FBG)
/CHG_FSW: R31.1, U5.36 (FSW_SYNC)
/CHG_HD1: Q1.4 (G), U5.27 (HIDRV1)
/CHG_HD2: Q4.4 (G), U5.19 (HIDRV2)
/CHG_ICHG: R29.1, U5.9 (ICHG)
/CHG_ILIM: R30.1, U5.10 (ILIM_HIZ)
/CHG_INT: R38.2, TP3.1, U5.3 (~INT)
/CHG_LD1: Q2.4 (G), U5.25 (LODRV1)
/CHG_LD2: Q3.4 (G), U5.21 (LODRV2)
/CHG_PG: R36.2, U5.6 (~PG)
/CHG_PG_K: D10.1 (K), R36.1
/CHG_REGN: C29.1, D8.2 (A), D9.2 (A), D10.2 (A), R23.1, R32.1, U5.24 (REGN)
/CHG_SRN: C35.2, C37.1, R26.2, U5.13 (SRN)
/CHG_SRP: C35.1, C36.1, R25.2, U5.14 (SRP)
/CHG_STAT1: R34.2, U5.4 (STAT1)
/CHG_STAT1_K: D8.1 (K), R34.1
/CHG_STAT2: R35.2, U5.5 (STAT2)
/CHG_STAT2_K: D9.1 (K), R35.1
/CHG_SW1: C27.2, L2.1, Q1.1 (S), Q1.2 (S), Q1.3 (S), Q2.5 (D), U5.28 (SW1)
/CHG_SW2: C28.2, L2.2, Q3.5 (D), Q4.1 (S), Q4.2 (S), Q4.3 (S), U5.18 (SW2)
/CHG_TS: J4.1, R32.2, R33.1, U5.8 (TS)
/CHG_VIN: C22.1, C23.1, C24.1, C25.1, Q1.5 (D), R17.2, R19.1
/CHG_VOUT: C31.1, C32.1, C33.1, C34.1, Q4.5 (D), R24.1, R25.1, TP2.1
/CH_DPDM: U2.4 (DP), U2.5 (DM)
/CH_VBUS: R16.2, U2.8 (VBUS)
/CH_VDD: C16.1, R15.2, U2.1 (VDD)
/ESC_BEC: J10.2, JP2.1 (A)
/ESC_PWM_3V: U4.8 (IO25), U11.2
/ESC_SIG: D25.1 (K), J10.1, R50.2, R53.1
/ESC_SIG_B: R50.1, U11.4
/GND: C1.2, C2.2, C3.2, C11.2, C12.2, C14.2, C15.2, C16.2, C17.2, C18.2, C20.2, C21.2, C22.2, C23.2, C24.2, C25.2, C26.2, C29.2, C30.2, C31.2, C32.2, C33.2, C34.2, C36.2, C37.2, C38.2, C39.2, C40.2, C41.2, C42.2, C44.2, C45.2, C46.2, C47.2, C48.2, C49.2, C50.2, C51.2, C52.2, C53.2, C54.2, C55.2, C56.2, C57.2, C58.2, C59.2, D1.2 (A2), D5.2 (A2), D12.2 (A), D13.1 (K), D14.2 (A), D15.2 (A), D18.2 (A), D19.2 (A), D20.2 (A), D21.2 (A), D22.2 (A), D25.2 (A), H1.1, H2.1, H3.1, H4.1, J1.2, J3.A1 (GND), J3.A12 (GND), J3.B1 (GND), J3.B12 (GND), J3.S1 (SHIELD), J4.2, J5.2, J6.4, J7.3, J8.3, J9.3, J10.3, J11.3, J12.2, J13.2, J14.2, J15.2, J16.2, J17.2, J18.2, J19.2, J20.4, Q2.1 (S), Q2.2 (S), Q2.3 (S), Q3.1 (S), Q3.2 (S), Q3.3 (S), R14.2, R22.2, R29.2, R30.2, R31.2, R33.2, R37.2, R42.2, R44.2, R46.2, R48.2, R53.2, R55.2, R56.2, R57.2, TH1.2, TP12.1, U1.3 (VSS), U1.28 (SRP), U1.29 (SRN), U2.11 (GND), U3.4 (GND), U4.14 (GND), U4.29 (GND), U5.17 (PGND), U5.22 (PGND), U5.37 (EP), U6.1 (SDO/SA0), U6.2 (SDX), U6.3 (SCX), U6.6 (GND), U6.7 (GND), U7.1, U7.3 (GND), U8.1, U8.3 (GND), U9.1, U9.3 (GND), U10.1, U10.3 (GND), U11.3 (GND), U12.3 (GND)
/I2C_SCL: J20.3, R69.2, U1.5 (SCL), U4.17 (IO22), U5.1 (SCL), U6.13 (SCL)
/I2C_SDA: J20.2, R68.2, U1.4 (SDA), U4.20 (IO21), U5.2 (SDA), U6.14 (SDA)
/IMU_INT1: U4.10 (IO27), U6.4 (INT1)
/LT_AUX: R62.1, U4.23 (IO5)
/LT_AUX_IN: R62.2, U14.6 (IN2)
/LT_AUX_LED: J16.1, R63.2
/LT_AUX_OUT: R63.1, U14.9 (OUT2), U14.10 (OUT2)
/LT_FRONT: R58.1, U4.27 (IO2)
/LT_FRONT_IN: R58.2, U13.2 (IN1)
/LT_FRONT_LED: J13.1, R51.2
/LT_FRONT_OUT: R51.1, U13.12 (OUT1), U13.13 (OUT1)
/LT_REAR: R59.1, U4.12 (IO12)
/LT_REAR_IN: R59.2, U13.6 (IN2)
/LT_REAR_LED: J14.1, R52.2
/LT_REAR_OUT: R52.1, U13.9 (OUT2), U13.10 (OUT2)
/LT_SPORT: R60.1, U4.28 (IO15)
/LT_SPORT_IN: R60.2, U14.2 (IN1)
/LT_SPORT_LED: J15.1, R61.2
/LT_SPORT_OUT: R61.1, U14.12 (OUT1), U14.13 (OUT1)
/LT_ST_A: U4.22 (IO18), U13.3 (ST1), U13.5 (ST2)
/LT_ST_B: U4.21 (IO19), U14.3 (ST1), U14.5 (ST2)
/NTC_ESC: C58.1, J18.1, R65.2, U4.3 (VN/IO39)
/NTC_MOTOR: C57.1, J17.1, R64.2, U4.2 (VP/IO36)
/OUT_EN_N: R49.2, U4.26 (IO4), U11.1, U12.1
/PWR_LED_A: D13.2 (A), R39.2
/PWR_SW: J5.1, R73.2
/RC_CH1_3V: U4.4 (IO34), U8.4
/RC_CH1_IN: J7.1, R43.1
/RC_CH1_R: D20.1 (K), R43.2, R44.1, U8.2
/RC_CH2_3V: U4.5 (IO35), U9.4
/RC_CH2_IN: J8.1, R45.1
/RC_CH2_R: D21.1 (K), R45.2, R46.1, U9.2
/RC_CH3_3V: U4.6 (IO32), U10.4
/RC_CH3_IN: J9.1, R47.1
/RC_CH3_R: D22.1 (K), R47.2, R48.1, U10.2
/RC_RX_3V: U4.25 (RX2/IO16), U7.4
/RC_RX_IN: J6.3, R41.1
/RC_RX_R: D19.1 (K), R41.2, R42.1, U7.2
/RC_TX: R40.1, U4.24 (TX2/IO17)
/RC_TX_OUT: D18.1 (K), J6.2, R40.2
/SERVO_PWM_3V: U4.9 (IO26), U12.2
/SERVO_SIG: D14.1 (K), J11.1, R54.2, R55.1
/SERVO_SIG_B: R54.1, U12.4
/SPORT_BTN: C59.1, D15.1 (K), R66.2, R67.2, U4.7 (IO33)
/SPORT_BTN_EXT: J19.1, R66.1
/USB_CC1: J3.A5 (CC1), U2.7 (CC1)
/USB_CC2: J3.B5 (CC2), U2.6 (CC2)
/VBAT: C41.1, C55.1, C56.1, D1.1 (A1), D11.2 (A), F1.2, R9.1, R24.2, R26.1, R27.1, TP6.1, U13.1 (VBB), U13.7 (VBB), U13.8 (VBB), U13.14 (VBB), U14.1 (VBB), U14.7 (VBB), U14.8 (VBB), U14.14 (VBB)
/VBAT_P: C42.1, C46.1, D11.1 (K), U3.3 (IN)
/VBAT_RAW: F1.1, J1.1
/VBUS: C17.1, C18.1, C26.1, D5.1 (A1), J3.A4 (VBUS), J3.A9 (VBUS), J3.B4 (VBUS), J3.B9 (VBUS), R15.1, R16.1, R17.1, R18.1, R20.1, TP1.1, U5.32 (VAC), U5.33 (VAC)
/VSERVO: C2.1, J6.1, J7.2, J8.2, J9.2, J11.2, J12.1, JP2.2 (B)

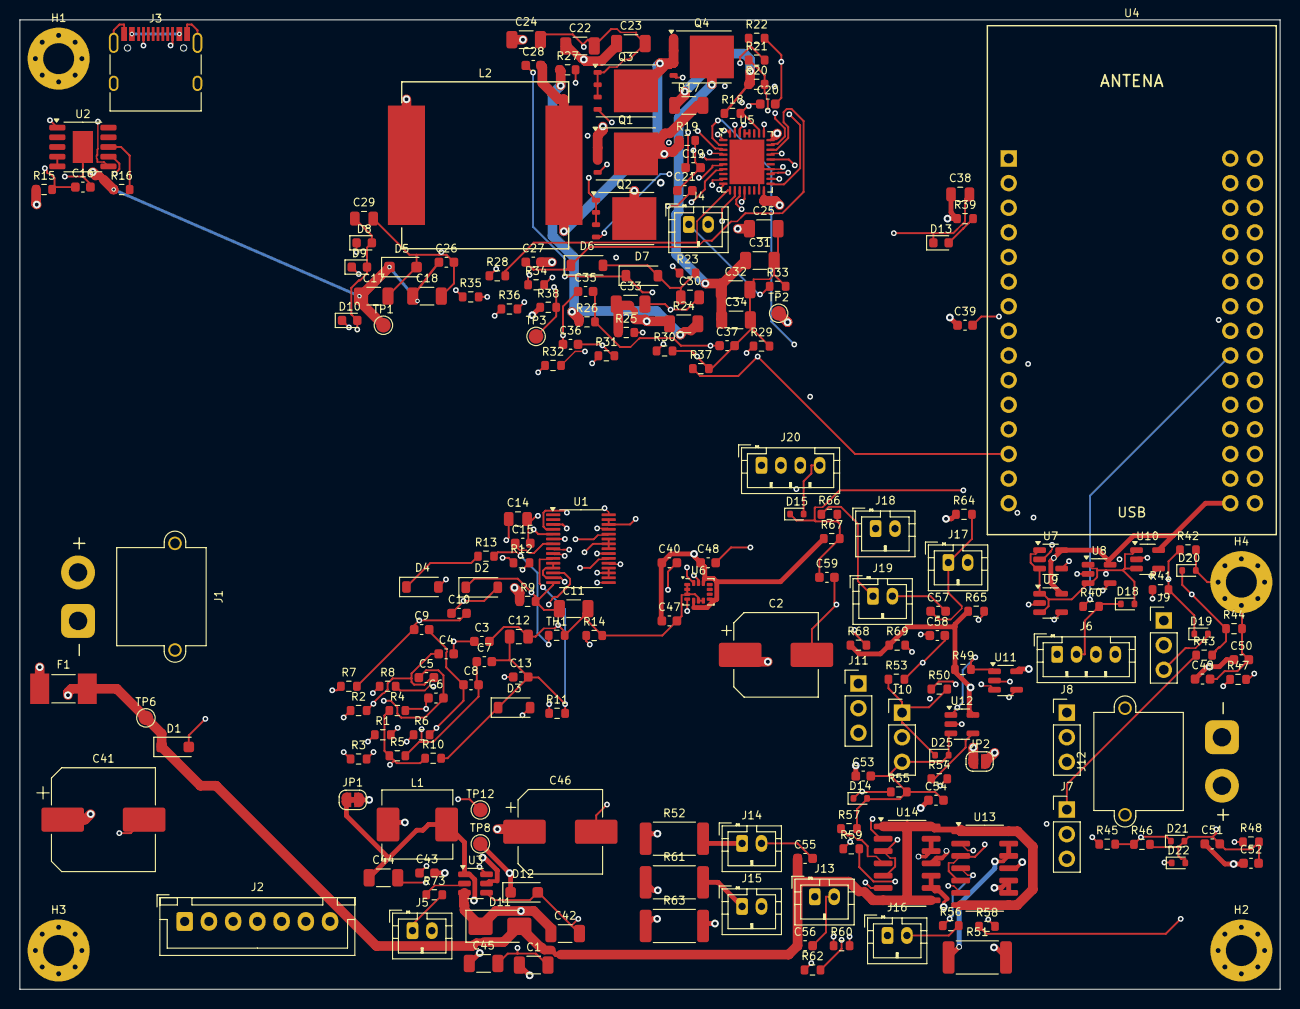
[picture p13: board cdj_revD.kicad_pcb from above]

Board: 4 copper layers, 130.0 x 100.0 mm, 204 parts (0 on the bottom side), 125 nets.
