Nicovf23/grupo-1800/(commit log)

2026-10-08 Add files via upload
    Archivo pre proyectó final sobre el carrito
2026-10-15 Add files via upload
    Caja de herramientas hecha en el software freecad (tarea 1)
    [LA CAJA 1800.FCStd]
2026-11-05 Create Archivos de kicad
    Aqui veremos todos los archivos relacionado a la pcb realizada en kicad
2026-11-05 Agregar archivos KiCad de la placa principal (rev D, EN DESARROLLO)
    Reemplaza el archivo vacio "Archivos de kicad" por una carpeta con:
    - Proyecto KiCad 9 editable (esquematico, PCB 130x100 mm 4 capas, libreria CDJ)
    - Archivos de fabricacion PRELIMINARES (no fabricar todavia)
    - Documentacion: esquematico PDF, vista 3D, BOM clasificada, pines del ESP32 DevKit V1
    - Reportes ERC/DRC y verificacion de netlist (575/575 pines)
    - Scripts que generan el diseno
    - AUDITORIA.md con el estado real: faltan 3 conexiones por rutear y
    verificaciones fisicas antes de produccion
    [BOM_revD.csv, PINES_DEVKIT_revD.csv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]
2026-11-05 Quitar scripts de generacion de la carpeta de KiCad
    La carpeta queda con el proyecto KiCad, los archivos de fabricacion
    preliminares, la documentacion y los reportes. Se actualizan README,
    AUDITORIA y NOTAS_DISENO para no referenciar los scripts.
    [BOM_revD.csv, PINES_DEVKIT_revD.csv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]
2026-11-05 Update fabrication notes for main board Rev D
2026-11-05 Revise BOM with updated components and values
    Updated BOM_revD.csv with new component values and descriptions.
    [BOM_revD.csv]
